snckwf/din-power-monitor-esp32-oled-shelly-em/images/cover-energy-monitor-shelly-esp32.png

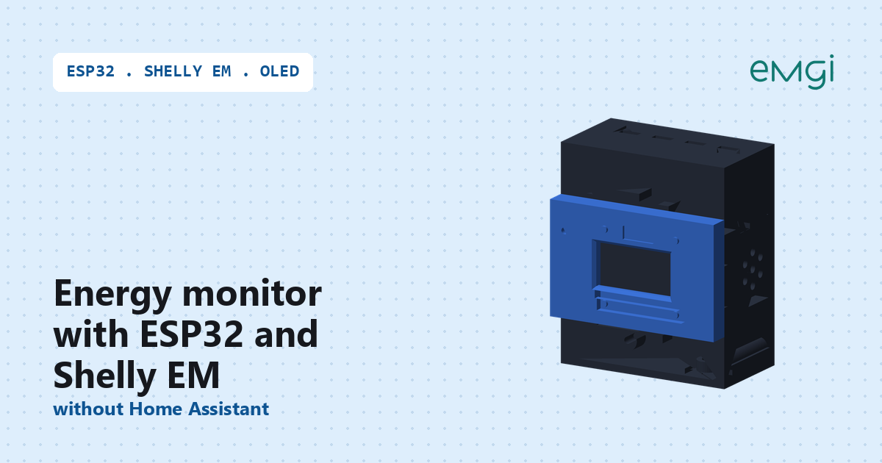
images/cover-energy-monitor-shelly-esp32.png
