snckwf/din-power-monitor-esp32-oled-shelly-em/case_3d/lid.stl

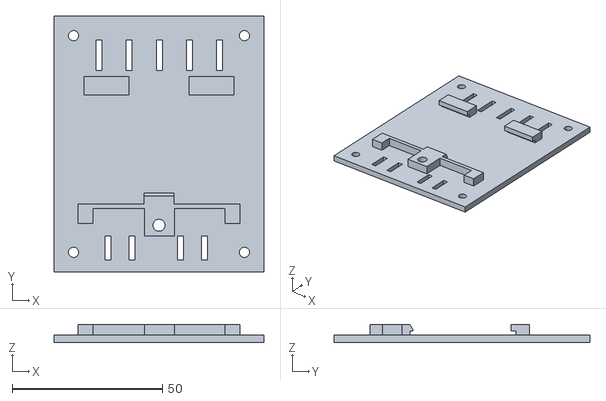
[picture p6: CAD file, 2026-10-13]
case_3d/lid.stl
69.8 x 85.0 x 6.00
