snckwf/din-power-monitor-esp32-oled-shelly-em/case_3d/bezel.stl

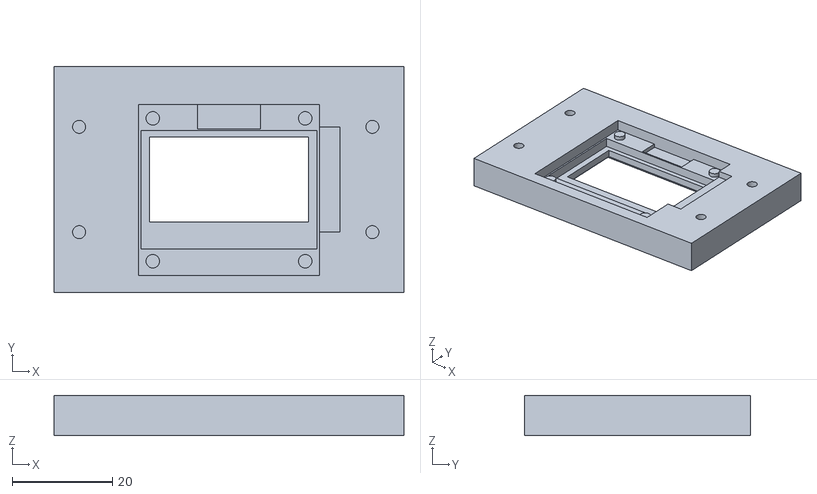
[picture p7: CAD file, 2026-10-13]
case_3d/bezel.stl
69.8 x 45.0 x 8.00
