snckwf/din-power-monitor-esp32-oled-shelly-em/(list of files, cad)

Other CAD files:
case_3d/supporto_din_display_esp32.scad
