snckwf/din-power-monitor-esp32-oled-shelly-em/(commit log)

2026-10-13 Monitor dei consumi su barra DIN con ESP32 che legge direttamente lo Shelly EM, senza Home Assistant
    Articolo: https://www.emgi.it/2026/10/13/monitor-consumi-barra-din-esp32-shelly-em-senza-home-assistant/
    [coperchio.stl, corpo.stl, fascia.stl, supporto_din_display_esp32.scad]
2026-10-28 Translate the repository to English
    Code comments, on-screen and web texts, documentation, diagrams and
    images translated to English; folders and files renamed in English.
    The linked articles on www.emgi.it stay in Italian.
    Claude-Session: https://claude.ai/code/session_01BdDk9w7oC75ueusgAfLjj3
    [bezel.stl, body.stl, din_enclosure_display_esp32.scad, lid.stl]
